JacobNeergaard/powerunit/README.md

# powerunit
Power distribution unit for race cars
