JacobNeergaard/powerunit/PCB/PowerUnit.csv

Reference | Value | Symbol | Footprint | ItemNo | Manufacturer | Part number
C1 | 1u | C | erp:C_0805_2012Metric | 220300 | Wurth Elektronik | 885012207078
C2 | 100n | C | erp:C_0805_2012Metric | 220250 | Wurth Elektronik | 885012207098
C3 | 100n | C | erp:C_0805_2012Metric | 220250 | Wurth Elektronik | 885012207098
C4 | 100n | C | erp:C_0805_2012Metric | 220250 | Wurth Elektronik | 885012207098
C5 | 100n | C | erp:C_0805_2012Metric | 220250 | Wurth Elektronik | 885012207098
C9 | 10u | CP | erp:CP_EIA-6032-15_Kemet-U | 221350 | AVX | TAJW106K025RNJ
C14 | 1u | C | erp:C_0805_2012Metric | 220300 | Wurth Elektronik | 885012207078
C15 | 220n | C | erp:C_0805_2012Metric | 220266 | Wurth Elektronik | 885012207074
D1 | 5.1V | D_Zener | erp:D_MiniMELF | 260002 | Vishay Semiconductors | TZM5231B-GS08
D2 | 5.1V | D_Zener | erp:D_MiniMELF | 260002 | Vishay Semiconductors | TZM5231B-GS08
D3 | SM6F15AY | D_Zener | erp:D_SOD-128 | 260003 | STMicroelectronics | SM6F15AY
D4 | SM6F15AY | D_Zener | erp:D_SOD-128 | 260003 | STMicroelectronics | SM6F15AY
D5 | SM6F15AY | D_Zener | erp:D_SOD-128 | 260003 | STMicroelectronics | SM6F15AY
D6 | SM6F15AY | D_Zener | erp:D_SOD-128 | 260003 | STMicroelectronics | SM6F15AY
D7 | SM6F15AY | D_Zener | erp:D_SOD-128 | 260003 | STMicroelectronics | SM6F15AY
D8 | LL4148 | D | erp:D_MiniMELF | 260000 | Vishay Semiconductors | LL4148-GS18
D9 | LL4148 | D | erp:D_MiniMELF | 260000 | Vishay Semiconductors | LL4148-GS18
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
U6 | BTS6143D | BTS61x | erp:TO-252-5_TabPin3X | 321000 | Infineon Technologies | BTS6143D
U7 | BTS6143D | BTS61x | erp:TO-252-5_TabPin3X | 321000 | Infineon Technologies | BTS6143D
U8 | BTS6143D | BTS61x | erp:TO-252-5_TabPin3X | 321000 | Infineon Technologies | BTS6143D
U9 | BTS6143D | BTS61x | erp:TO-252-5_TabPin3X | 321000 | Infineon Technologies | BTS6143D
U10 | BTS6143D | BTS61x | erp:TO-252-5_TabPin3X | 321000 | Infineon Technologies | BTS6143D
U11 | BTS6143D | BTS61x | erp:TO-252-5_TabPin3X | 321000 | Infineon Technologies | BTS6143D
U12 | BTS6143D | BTS61x | erp:TO-252-5_TabPin3X | 321000 | Infineon Technologies | BTS6143D
U13 | BTS6143D | BTS61x | erp:TO-252-5_TabPin3X | 321000 | Infineon Technologies | BTS6143D
