JacobNeergaard/powerunit/Enclosure/PowerUnitTop.step

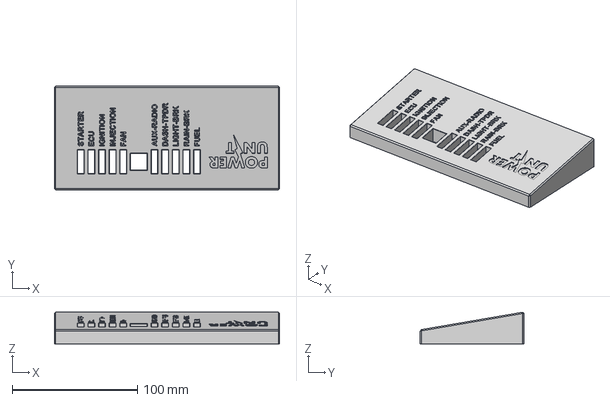
[picture p1: CAD file, 2020-05-13]
Enclosure/PowerUnitTop.step
180.0 x 83.0 x 25.2 mm
