JacobNeergaard/powerunit/SwitchPanel/SwitchPanel.dxf

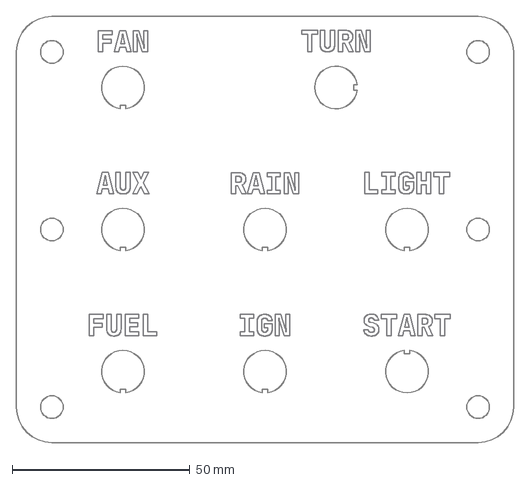
[picture p2: CAD file, 2020-05-02]
SwitchPanel/SwitchPanel.dxf
140.0 x 120.0 mm
