JacobNeergaard/powerunit/Enclosure/PowerUnitBottom.step

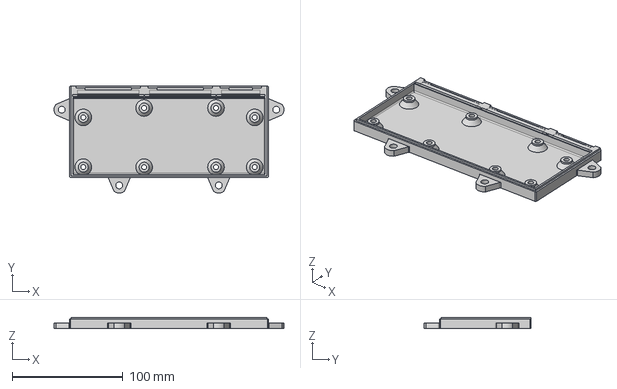
[picture p3: CAD file, 2020-05-13]
Enclosure/PowerUnitBottom.step
208.0 x 97.0 x 10.0 mm
