JacobNeergaard/powerunit/(list of files, cad)

Other CAD files:
Enclosure/PowerUnitBottom.stl
Enclosure/PowerUnitTop.stl
