JacobNeergaard/powerunit/PCB/PowerUnit.pdf

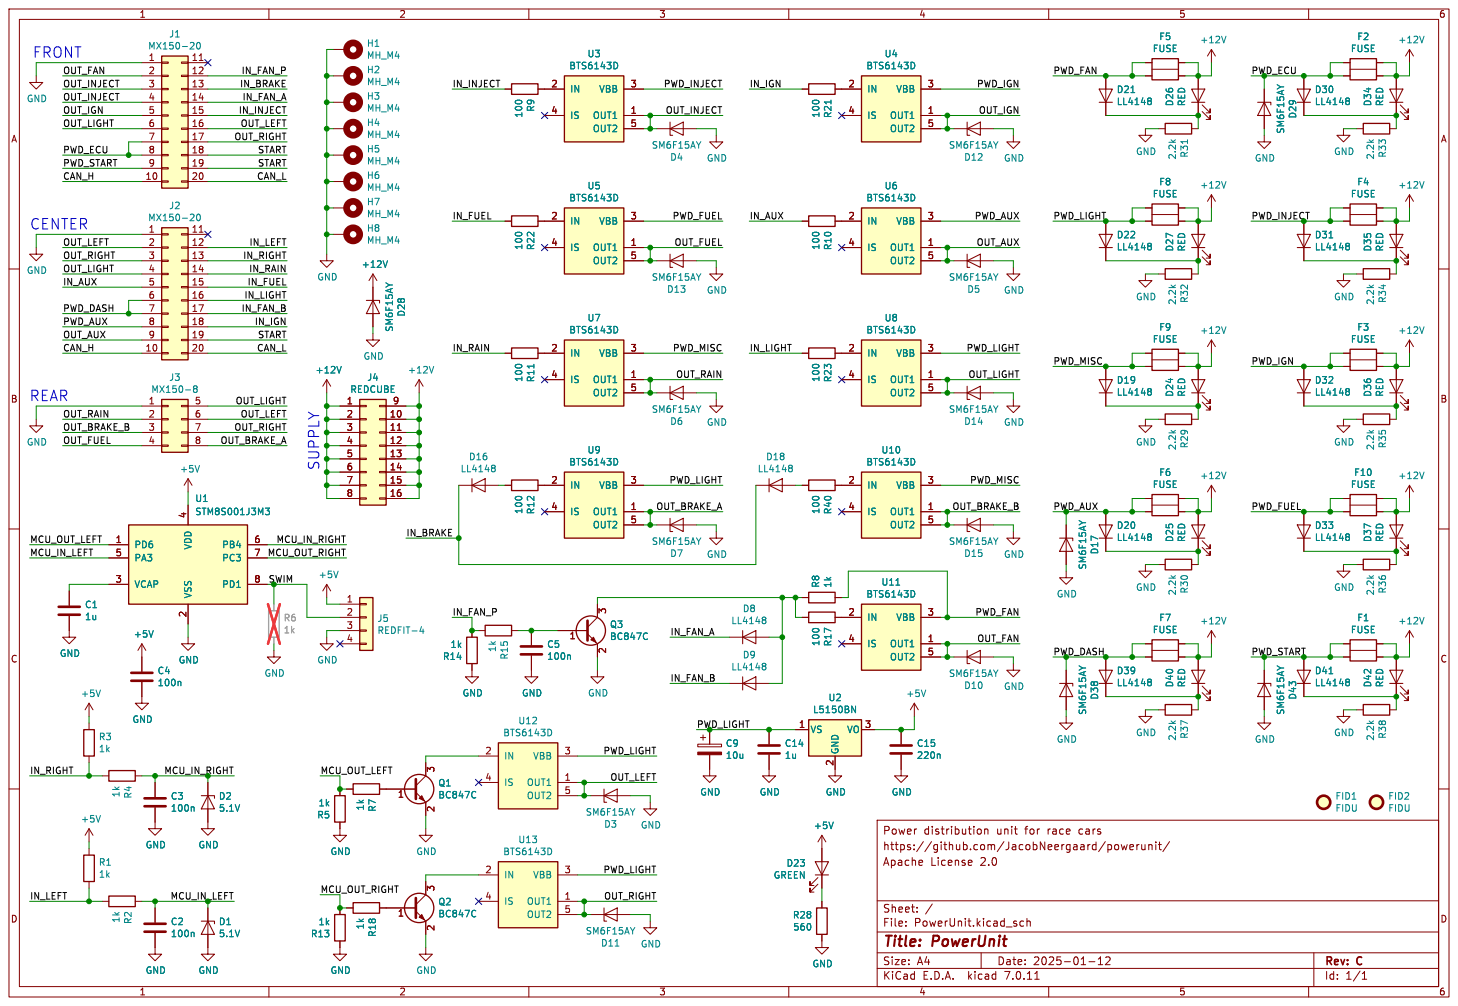
[picture p4: page 1]

Id: 1/1 Title: PowerUnit File: PowerUnit.kicad_sch Sheet: / Apache License 2.0
