JacobNeergaard/powerunit/PCB/PowerUnit-F_Fab.pdf

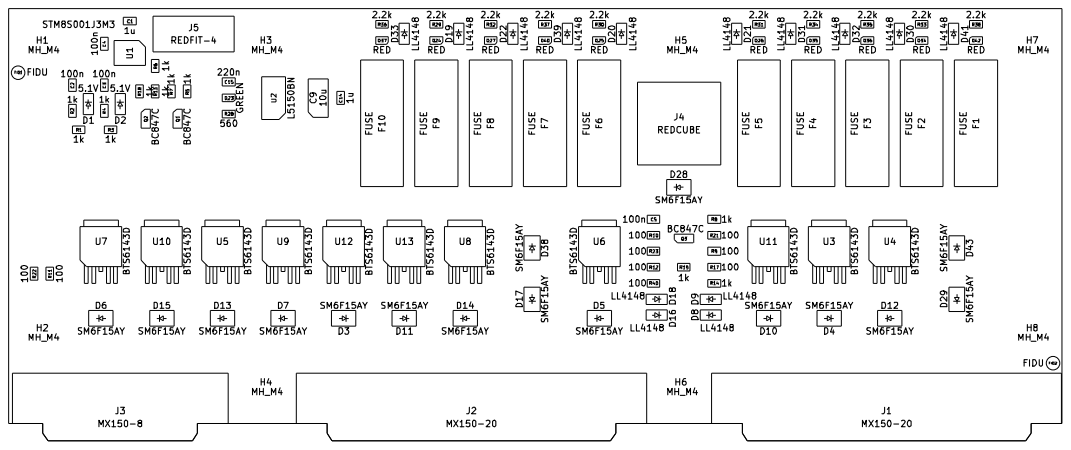
[picture p5: page 1]
