JacobNeergaard/powerunit/SwitchPanel/SwitchPanel.pdf

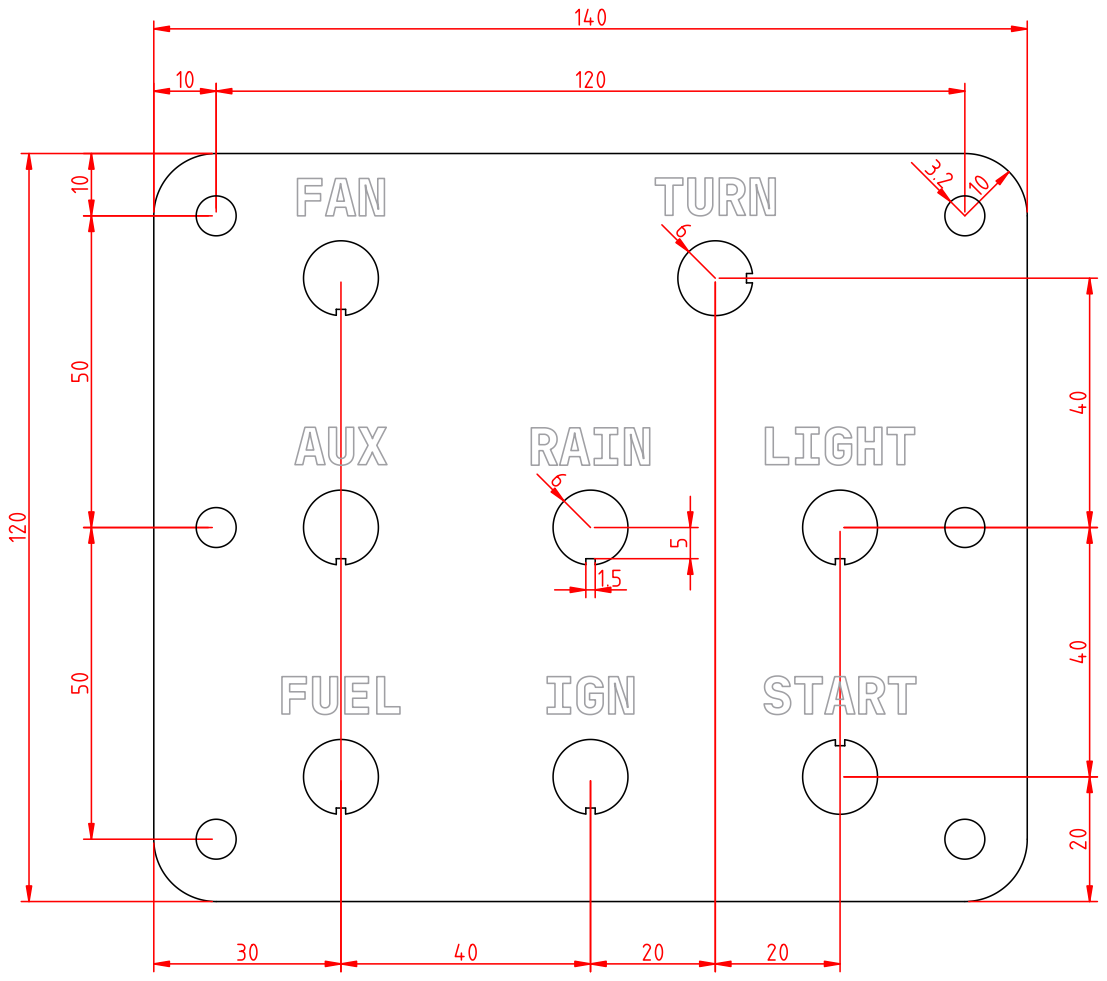
[picture p6: page 1]
