JacobNeergaard/powerunit/PCB/PowerUnit.kicad_pcb

## KiCad design PCB/PowerUnit.kicad_pcb (2025-01-13)

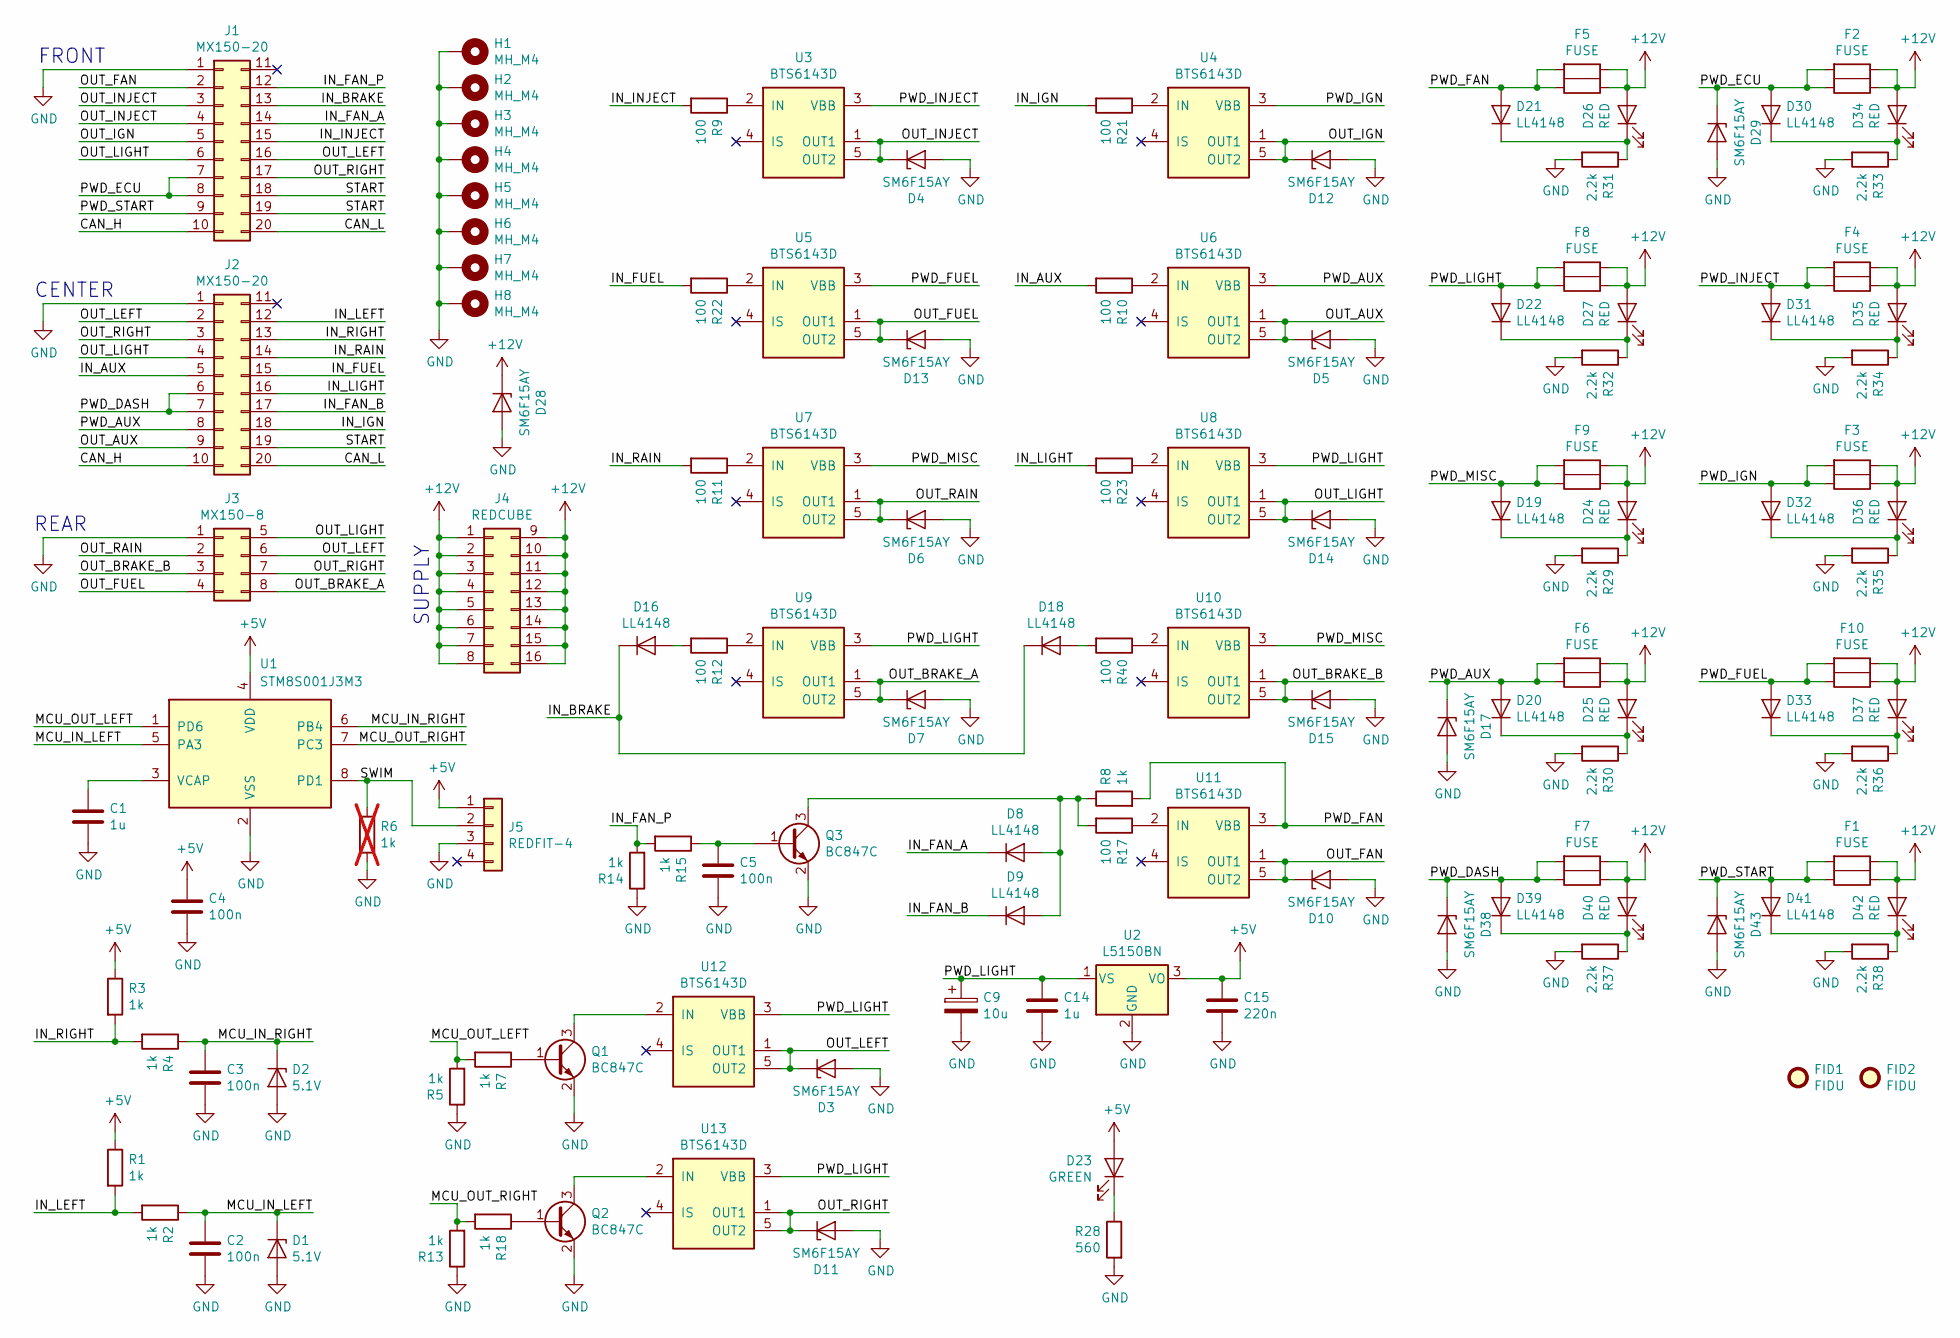
[picture p7: schematic PowerUnit.kicad_sch]

Parts:
C1, C14: 1u; C_0805_2012Metric
C2, C3, C4, C5: 100n; C_0805_2012Metric
C9: 10u; CP_EIA-6032-15_Kemet-U
C15: 220n; C_0805_2012Metric
D1, D2: 5.1V; D_MiniMELF
D3, D4, D5, D6, D7, D10, D11, D12, D13, D14, D15, D17, D28, D29, D38, D43: SM6F15AY; D_SOD-128
D8, D9, D16, D18, D19, D20, D21, D22, D30, D31, D32, D33, D39, D41: LL4148; D_MiniMELF
D23: GREEN; LED_0805_2012Metric
D24, D25, D26, D27, D34, D35, D36, D37, D40, D42: RED; LED_0805_2012Metric
F1, F2, F3, F4, F5, F6, F7, F8, F9, F10: FUSE; Keystone_FuseHolder
FID1, FID2: FIDU; Fiducial_1mm_Mask2mm
H1, H2, H3, H4, H5, H6, H7, H8: MH_M4; MountingHole_4.3mm_M4_Pad_Via
J1, J2: MX150-20; Molex_MX150_2x10_Header
J3: MX150-8; Molex_MX150_2x04_Header
J4: REDCUBE; Wurth_WP-BUCF_M6
J5: REDFIT-4; Wurth_WR-WST_IDC_4
Q1, Q2, Q3: BC847C; SOT-23
R1, R2, R3, R4, R5, R7, R8, R13, R14, R15, R18: 1k; R_0805_2012Metric
R6: 1k; R_0805_2012Metric; not fitted
R9, R10, R11, R12, R17, R21, R22, R23, R40: 100; R_0805_2012Metric
R28: 560; R_0805_2012Metric
R29, R30, R31, R32, R33, R34, R35, R36, R37, R38: 2.2k; R_0805_2012Metric
U1: STM8S001J3M3; SOIC-8_3.9x4.9mm_P1.27mm
U2: L5150BN; SOT-223-3_TabPin2
U3, U4, U5, U6, U7, U8, U9, U10, U11, U12, U13: BTS6143D; TO-252-5_TabPin3X

Connections:
+5V: C4.1, C15.1, D23.2 (A), J5.1, R1.1, R3.1, U1.4 (VDD), U2.3 (VO)
+12V: D24.2 (A), D25.2 (A), D26.2 (A), D27.2 (A), D28.1 (K), D34.2 (A), D35.2 (A), D36.2 (A), D37.2 (A), D40.2 (A), D42.2 (A), F1.1A, F1.1B, F2.1A, F2.1B, F3.1A, F3.1B, F4.1A, F4.1B, F5.1A, F5.1B, F6.1A, F6.1B, F7.1A, F7.1B, F8.1A, F8.1B, F9.1A, F9.1B, F10.1A, F10.1B, J4.1, J4.2, J4.3, J4.4, J4.5, J4.6, J4.7, J4.8, J4.9, J4.10, J4.11, J4.12, J4.13, J4.14, J4.15, J4.16
/CAN_H: J1.10, J2.10
/CAN_L: J1.20, J2.20
/IN_AUX: J2.5, R10.2
/IN_BRAKE: D16.1 (K), D18.1 (K), J1.13
/IN_FAN_A: D8.1 (K), J1.14
/IN_FAN_B: D9.1 (K), J2.17
/IN_FAN_P: J1.12, R14.2, R15.2
/IN_FUEL: J2.15, R22.2
/IN_IGN: J2.18, R21.2
/IN_INJECT: J1.15, R9.2
/IN_LEFT: J2.12, R1.2, R2.2
/IN_LIGHT: J2.16, R23.2
/IN_RAIN: J2.14, R11.2
/IN_RIGHT: J2.13, R3.2, R4.2
/MCU_IN_LEFT: C2.1, D1.1 (K), R2.1, U1.5 (PA3)
/MCU_IN_RIGHT: C3.1, D2.1 (K), R4.1, U1.6 (PB4)
/MCU_OUT_LEFT: R5.2, R7.2, U1.1 (PD6)
/MCU_OUT_RIGHT: R13.2, R18.2, U1.7 (PC3)
/OUT_AUX: D5.1 (K), J2.9, U6.1 (OUT1), U6.5 (OUT2)
/OUT_BRAKE_A: D7.1 (K), J3.8, U9.1 (OUT1), U9.5 (OUT2)
/OUT_BRAKE_B: D15.1 (K), J3.3, U10.1 (OUT1), U10.5 (OUT2)
/OUT_FAN: D10.1 (K), J1.2, U11.1 (OUT1), U11.5 (OUT2)
/OUT_FUEL: D13.1 (K), J3.4, U5.1 (OUT1), U5.5 (OUT2)
/OUT_IGN: D12.1 (K), J1.5, U4.1 (OUT1), U4.5 (OUT2)
/OUT_INJECT: D4.1 (K), J1.3, J1.4, U3.1 (OUT1), U3.5 (OUT2)
/OUT_LEFT: D3.1 (K), J1.16, J2.2, J3.6, U12.1 (OUT1), U12.5 (OUT2)
/OUT_LIGHT: D14.1 (K), J1.6, J2.4, J3.5, U8.1 (OUT1), U8.5 (OUT2)
/OUT_RAIN: D6.1 (K), J3.2, U7.1 (OUT1), U7.5 (OUT2)
/OUT_RIGHT: D11.1 (K), J1.17, J2.3, J3.7, U13.1 (OUT1), U13.5 (OUT2)
/PWD_AUX: D17.1 (K), D20.2 (A), F6.2A, F6.2B, J2.8, U6.3 (VBB)
/PWD_DASH: D38.1 (K), D39.2 (A), F7.2A, F7.2B, J2.6, J2.7
/PWD_ECU: D29.1 (K), D30.2 (A), F2.2A, F2.2B, J1.7, J1.8
/PWD_FAN: D21.2 (A), F5.2A, F5.2B, R8.2, U11.3 (VBB)
/PWD_FUEL: D33.2 (A), F10.2A, F10.2B, U5.3 (VBB)
/PWD_IGN: D32.2 (A), F3.2A, F3.2B, U4.3 (VBB)
/PWD_INJECT: D31.2 (A), F4.2A, F4.2B, U3.3 (VBB)
/PWD_LIGHT: C9.1, C14.1, D22.2 (A), F8.2A, F8.2B, U2.1 (VS), U8.3 (VBB), U9.3 (VBB), U12.3 (VBB), U13.3 (VBB)
/PWD_MISC: D19.2 (A), F9.2A, F9.2B, U7.3 (VBB), U10.3 (VBB)
/PWD_START: D41.2 (A), D43.1 (K), F1.2A, F1.2B, J1.9
/START: J1.18, J1.19, J2.19
/SWIM: J5.2, R6.1, U1.8 (PD1)
GND: C1.2, C2.2, C3.2, C4.2, C5.2, C9.2, C14.2, C15.2, D1.2 (A), D2.2 (A), D3.2 (A), D4.2 (A), D5.2 (A), D6.2 (A), D7.2 (A), D10.2 (A), D11.2 (A), D12.2 (A), D13.2 (A), D14.2 (A), D15.2 (A), D17.2 (A), D28.2 (A), D29.2 (A), D38.2 (A), D43.2 (A), H1.1, H2.1, H3.1, H4.1, H5.1, H6.1, H7.1, H8.1, J1.1, J2.1, J3.1, J5.3, Q1.2 (E), Q2.2 (E), Q3.2 (E), R5.1, R6.2, R13.1, R14.1, R28.2, R29.2, R30.2, R31.2, R32.2, R33.2, R34.2, R35.2, R36.2, R37.2, R38.2, U1.2 (VSS), U2.2 (GND)
unnamed: D8.2 (A), D9.2 (A), Q3.3 (C), R8.1, R17.2
unnamed: D16.2 (A), R12.2
unnamed: D18.2 (A), R40.2
unnamed: D19.1 (K), D24.1 (K), R29.1
unnamed: D20.1 (K), D25.1 (K), R30.1
unnamed: D21.1 (K), D26.1 (K), R31.1
unnamed: D22.1 (K), D27.1 (K), R32.1
unnamed: D23.1 (K), R28.1
unnamed: D30.1 (K), D34.1 (K), R33.1
unnamed: D31.1 (K), D35.1 (K), R34.1
unnamed: D32.1 (K), D36.1 (K), R35.1
unnamed: D33.1 (K), D37.1 (K), R36.1
unnamed: D39.1 (K), D40.1 (K), R37.1
unnamed: D41.1 (K), D42.1 (K), R38.1
unnamed: Q1.1 (B), R7.1
unnamed: Q1.3 (C), U12.2 (IN)
unnamed: Q2.1 (B), R18.1
unnamed: Q2.3 (C), U13.2 (IN)
unnamed: C5.1, Q3.1 (B), R15.1
unnamed: C1.1, U1.3 (VCAP)
unnamed: R9.1, U3.2 (IN)
unnamed: R21.1, U4.2 (IN)
unnamed: R22.1, U5.2 (IN)
unnamed: R10.1, U6.2 (IN)
unnamed: R11.1, U7.2 (IN)
unnamed: R23.1, U8.2 (IN)
unnamed: R12.1, U9.2 (IN)
unnamed: R40.1, U10.2 (IN)
unnamed: R17.1, U11.2 (IN)

Notes on the sheet:
SUPPLY
REAR
FRONT
CENTER

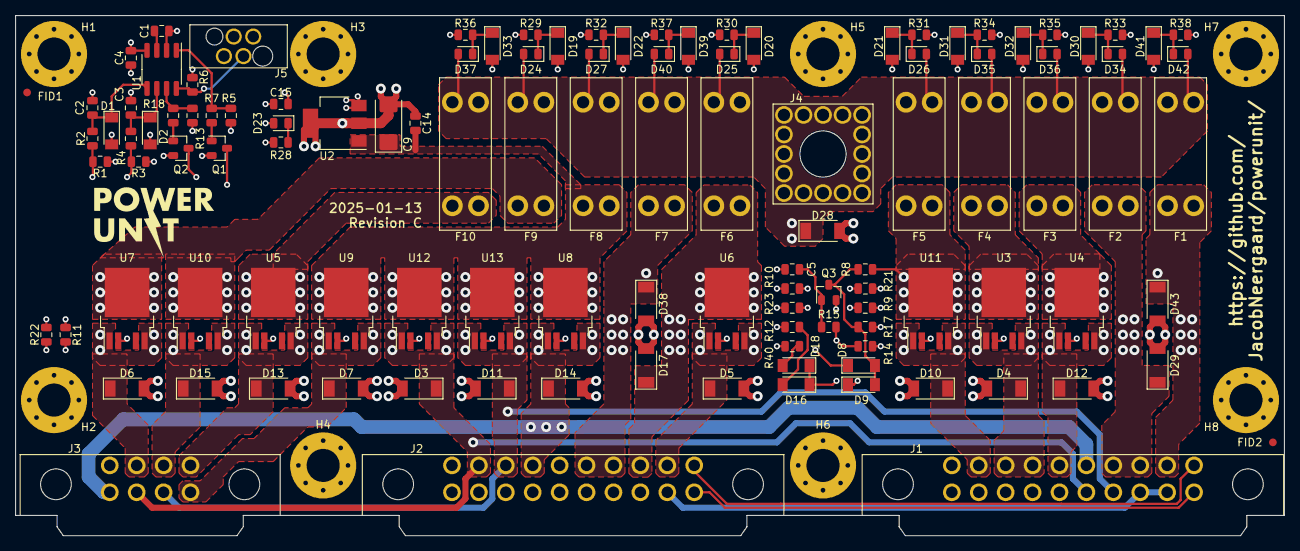
[picture p8: board PowerUnit.kicad_pcb from above]

Board: 4 copper layers, 165.0 x 67.6 mm, 124 parts (0 on the bottom side), 73 nets.
