JacobNeergaard/powerunit/(commit log)

2019-10-24 first draft
    [PowerUnit.csv, PowerUnit.kicad_pcb, PowerUnit.sch]
2019-12-02 Correct MCU Ports
    [PowerUnit.sch]
2019-12-02 Added PDF and update timestamp
    [PowerUnit.sch]
2019-12-02 First Layout added
    [PowerUnit.kicad_pcb]
2019-12-02 added some components
    [PowerUnit.kicad_pcb]
2019-12-02 Added SWIM connector
    [PowerUnit.csv, PowerUnit.kicad_pcb, PowerUnit.sch]
2019-12-03 Changed TVS diodes
    [PowerUnit.csv, PowerUnit.kicad_pcb, PowerUnit.sch]
2019-12-04 All footprints added
    [PowerUnit.csv, PowerUnit.kicad_pcb, PowerUnit.sch]
2019-12-14 First PCB Layout done
    [PowerUnit.csv, PowerUnit.kicad_pcb, PowerUnit.sch]
2019-12-14 Now with first Gerber
    [PowerUnit-B_Cu.gbr, PowerUnit-B_Mask.gbr, PowerUnit-Edge_Cuts.gbr, PowerUnit-F_Cu.gbr, PowerUnit-F_Mask.gbr, PowerUnit-F_Paste.gbr, PowerUnit-F_SilkS.gbr, PowerUnit-In1_Cu.gbr]
2019-12-15 fix labels
    [PowerUnit.sch]
2019-12-15 Fix thermal relief
    [PowerUnit-B_Cu.gbr, PowerUnit-B_Mask.gbr, PowerUnit-Edge_Cuts.gbr, PowerUnit-F_Cu.gbr, PowerUnit-F_Mask.gbr, PowerUnit-F_Paste.gbr, PowerUnit-F_SilkS.gbr, PowerUnit-In1_Cu.gbr]
2019-12-15 Added revision
    [PowerUnit-B_Cu.gbr, PowerUnit-B_Mask.gbr, PowerUnit-Edge_Cuts.gbr, PowerUnit-F_Cu.gbr, PowerUnit-F_Mask.gbr, PowerUnit-F_Paste.gbr, PowerUnit-F_SilkS.gbr, PowerUnit-In1_Cu.gbr]
2020-01-02 fix Fab
    [PowerUnit.csv, PowerUnit.kicad_pcb, PowerUnit.sch]
2020-01-03 Harness BOM
    [BOM.csv]
2020-01-03 Harness BOM update
    [BOM.csv]
2020-02-06 Enclosure and logo
    [PowerUnitBottom.step, PowerUnitTop.step]
2020-02-09 Added STL and SwitchPanel
    [BOM.csv, PowerUnitBottom.stl, PowerUnitTop.stl, SwitchPanel.dxf]
2020-03-11 Changed debug connector
    [PowerUnit.sch]
2020-03-12 updated MCU symbol
    [PowerUnit.sch]
2020-04-16 new high-side switch and debugconn
    [PowerUnit.csv, PowerUnit.sch]
2020-04-24 remove resistors / New layout
    [PowerUnit.csv, PowerUnit.kicad_pcb, PowerUnit.sch]
2020-04-24 Done RevB
    [PowerUnit-B_Cu.gbr, PowerUnit-B_Mask.gbr, PowerUnit-Edge_Cuts.gbr, PowerUnit-F_Cu.gbr, PowerUnit-F_Mask.gbr, PowerUnit-F_Paste.gbr, PowerUnit-F_SilkS.gbr, PowerUnit-In1_Cu.gbr]
2020-05-02 Updated switch panel
    [SwitchPanel.dxf]
2020-05-13 update enclosure
    [PowerUnitBottom.step, PowerUnitBottom.stl, PowerUnitTop.step, PowerUnitTop.stl]
2022-02-20 update with purchase info
    [PowerUnit.csv]
2022-02-20 fix CSV file
    [PowerUnit.csv]
2022-02-20 Add header
    [PowerUnit.csv]
2022-02-20 remove dual FLIGHT connector
    [BOM.csv]
2023-03-04 Updated to KiCAD 7.0
    [PowerUnit.kicad_pcb]
2023-03-04 Convert Schematic to KiCAD 7.0
    [PowerUnit.kicad_sch, PowerUnit.sch]
2023-03-04 Remove old KiCAD cache
2023-03-04 Add Fan pull-up
    [PowerUnit.csv, PowerUnit.kicad_sch]
2024-12-18 Update 2-pin male part no
    [BOM.csv]
2025-01-12 Production data Rev C
    [PowerUnit-B_Cu.gbr, PowerUnit-B_Mask.gbr, PowerUnit-Edge_Cuts.gbr, PowerUnit-F_Cu.gbr, PowerUnit-F_Mask.gbr, PowerUnit-F_Paste.gbr, PowerUnit-F_SilkS.gbr, PowerUnit-F_Silkscreen.gbr]
2025-01-13 Update Assembly data to Rev C
    [PowerUnit.csv, PowerUnit.kicad_pcb, PowerUnit.kicad_sch]
2025-01-13 Update Silkscreen design
    [PowerUnit-B_Cu.gbr, PowerUnit-B_Mask.gbr, PowerUnit-Edge_Cuts.gbr, PowerUnit-F_Cu.gbr, PowerUnit-F_Mask.gbr, PowerUnit-F_Paste.gbr, PowerUnit-F_Silkscreen.gbr, PowerUnit-In1_Cu.gbr]
